OfficialKris/ev-microcontroller/kicad/ev-microcontroller.kicad_pcb

## KiCad design kicad/ev-microcontroller.kicad_pcb (2022-10-09)

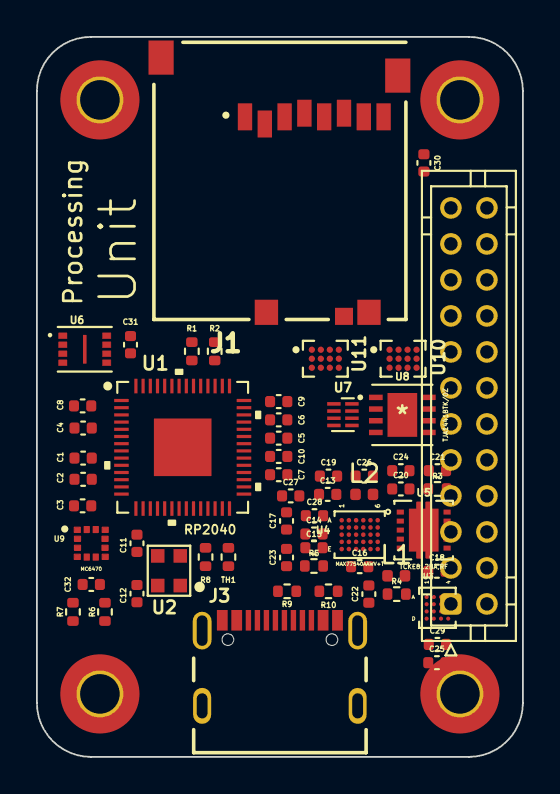
[picture p1: board ev-microcontroller.kicad_pcb from above]

Board: 2 copper layers, 27.0 x 40.0 mm, 63 parts (0 on the bottom side), 57 nets, no tracks yet.

Parts:
C1, C2, C3, C4, C5, C6, C7, C8, C9, C10, C12, C13, C14, C20, C23, C24, C25, C27, C30, C31, C32: 0.1µF; C_0402_1005Metric
C11: 15pF; C_0402_1005Metric
C15, C16, C17, C22, C26, C28, C29: 22µF; C_0402_1005Metric
C18, C19: 1µF; C_0402_1005Metric
C21: 100pF; C_0402_1005Metric
H1, H2, H3, H4: M2; MountingHole_2.2mm_M2_Pad_TopBottom
J1: MEM2051-00-195-00-A_REVC; GCT_MEM2051-00-195-00-A_REVC
J2: Conn_02x20_Odd_Even; JST_PHD_B24B-PHDSS_2x12_P2.00mm_Vertical
J3: USB4105-GF-A; GCT_USB4105-GF-A
L1, L2: 0.47µH; L_0402_1005Metric
R1, R2: 27.4; R_0402_1005Metric
R3: 36k; R_0402_1005Metric
R4: 75k; R_0402_1005Metric
R5: 100k; R_0402_1005Metric
R6, R7: 4.7k; R_0402_1005Metric
R8: 470k; R_0402_1005Metric
R9, R10: 5.1k; R_0402_1005Metric
TH1: NTC; R_0402_1005Metric
U1: RP2040; IC57_RP2040
U2: DSC1001DI1-025.0000T; OSCDFN250X200X89-4N
U3: FPF3042UCX
U4: MAX77540AAWV+T; 21-100414_W302P2Z+1_MXM
U5: TCKE812NA,RF; WSON10B_TOS
U6: GD25Q40CEIGR; PSON50P200X300X50-9N
U7: UM3202; DFN-8_1.7x1.35mm_P0.4mm
U8: TJA1441BTK/0Z; HVSON8_TJA1441BTK_0Z_NXP
U9: MC6470; PQFN50P200X200X100-12N
U10, U11: MAX11613EWCT; BGA12N50P3X4_188X221X69N

Connections:
+1V1: C8.1, C9.1, C10.1, U1.23 (DVDD), U1.45 (VREG_VOUT), U1.50 (DVDD)
+3V3: C1.1, C2.1, C3.1, C4.1, C5.1, C6.1, C7.1, C12.1, C22.2, C26.2, C29.2, C30.1, C31.1, C32.1, J1.4 (VDD), J2.11, J2.13, L2.1, R6.1, R7.1, R8.1, U1.1 (IOVDD), U1.10 (IOVDD), U1.22 (IOVDD), U1.26 (RUN), U1.33 (IOVDD), U1.42 (IOVDD), U1.43 (ADC_AVDD), U1.44 (VREG_VIN), U1.48 (USB_VDD), U1.49 (IOVDD), U2.4 (VDD), U4.C6 (SNS2), U6.8 (VCC), U10.C1 (VDD), U11.C1 (VDD)
+5V: C15.2, C16.2, C17.2, J2.12, J2.14, L1.1, U4.C1 (SNS1), U8.3 (VCC)
/MCU/CLOCK: C11.1, U1.20 (XIN), U2.3 (OUT)
/Power/V_OUT: C19.1, C27.1, C28.2, U4.A3 (IN1), U4.A4 (IN2), U4.C2 (EN1), U4.C5 (EN2), U4.E5 (SYS), U5.6 (VOUT), U5.7 (VOUT), U5.8 (VOUT)
CAN_HI: J2.2, J2.4
CAN_LO: J2.1, J2.3, U8.6 (CANL)
DN: J3.A7 (DN1), J3.B7 (DN2), R2.2
DP: J3.A6 (DP1), J3.B6 (DP2), R1.2
GND: C1.2, C2.2, C3.2, C4.2, C5.2, C6.2, C7.2, C8.2, C9.2, C10.2, C11.2, C12.2, C13.2, C14.1, C15.1, C16.1, C17.1, C18.2, C19.2, C21.2, C22.1, C23.2, C24.2, C26.1, C27.2, C28.1, C29.1, C30.2, C31.2, H1.1, H2.1, H3.1, H4.1, J1.6 (VSS), J1.10 (SHIELD), J1.11 (SHIELD), J1.12 (SHIELD), J1.13 (SHIELD), J2.8, J2.15, J2.16, J3.A1_B12 (GND), J3.B1_A12 (GND), J3.S1 (SHELL_GND), J3.S2 (SHELL_GND), J3.S3 (SHELL_GND), J3.S4 (SHELL_GND), R3.2, R4.2, R5.1, R9.2, R10.1, TH1.2, U1.19 (TESTEN), U1.57 (GND), U2.2 (GND), U3.D1 (GND), U3.D2 (GND), U4.A1 (PGND1), U4.A6 (PGND2), U4.C3 (I2C_EN), U4.C4 (IRQB), U4.D3 (ADDR), U4.D5 (ALT_IN), U4.D6 (SDA), U4.E3 (AGND), U4.E6 (SCL), U5.11 (GND), U6.4 (VSS), U8.2 (GND), U8.8 (S), U9.1 (A5), U9.9 (GND), U10.B1 (GND), U10.B2 (GND), U10.B3 (GND), U10.B4 (GND), U10.C2 (GND), U11.B1 (GND), U11.B2 (GND), U11.B3 (GND), U11.B4 (GND), U11.C2 (GND)
GPIO_1: J2.18, U1.29 (GPIO18)
GPIO_2: J2.20, U1.30 (GPIO19)
GPIO_3: J2.22, U1.31 (GPIO20)
GPIO_4: J2.24, U1.32 (GPIO21)
GPIO_8: U1.18 (GPIO15), U1.37 (GPIO25)
GPIO_12_A1: J2.17, U1.41 (GPIO29/ADC3)
GPIO_13_A2: J2.19, U1.40 (GPIO28/ADC2)
GPIO_14_A3: J2.21, U1.39 (GPIO27/ADC1)
GPIO_CAN_TXD: U1.27 (GPIO16), U1.28 (GPIO17)
GPIO_CD: J1.9 (CD), U1.13 (GPIO10)
GPIO_TEMP: R8.2, TH1.1, U1.38 (GPIO26/ADC0)
unnamed: C18.1, U4.E1 (FPWM1B), U4.E2 (FPWM2B), U4.E4 (VL)
unnamed: C20.1, U4.B1 (BST1)
unnamed: C20.2, L1.2, U4.A2 (LX1), U4.B2 (LX1)
unnamed: C21.1, U5.1 (DV/DT)
unnamed: C23.1, U4.D4 (VDD)
unnamed: C25.1, U4.B6 (BST2)
unnamed: C25.2, L2.2, U4.A5 (LX2), U4.B5 (LX2)
unnamed: C32.2, U9.3 (VDDIO), U9.7 (VDDM)
unnamed: J3.A5 (CC1), R9.1
unnamed: J3.B5 (CC2), R10.2
unnamed: R1.1, U1.47 (USB_DP)
unnamed: R2.1, U1.46 (USB_DM)
unnamed: R3.1, U5.10 (ILIM)
unnamed: R4.1, U4.D2 (SEL2)
unnamed: R5.2, U4.D1 (SEL1)
QSPI_SCLK: U1.52 (QSPI_SCLK), U6.6 (SCLK)
QSPI_SD0: U1.53 (QSPI_SD0), U6.5 (SI(IO0))
QSPI_SD1: U1.55 (QSPI_SD1), U6.2 (SO(IO1))
QSPI_SD2: U1.54 (QSPI_SD2), U6.3 (WP#(IO2))
QSPI_SD3: U1.51 (QSPI_SD3), U6.7 (HOLD#(IO3))
QSPI_SS: U1.56 (QSPI_SS_N), U6.1 (CS#)
SCL_0: U1.12 (GPIO9), U11.C4 (SCL)
SCL_1: R7.2, U1.9 (GPIO7), U9.12 (SCL), U10.C4 (SCL)
SDA_0: U1.11 (GPIO8), U11.C3 (SDA)
SDA_1: R6.2, U1.8 (GPIO6), U9.2 (SDA), U10.C3 (SDA)
SD_CLK: J1.5 (CLK), U1.7 (GPIO5)
SD_CMD: J1.3 (CMD), U1.6 (GPIO4)
SD_DAT0: J1.7 (DAT0), U1.2 (GPIO0)
SD_DAT1: J1.8 (DAT1), U1.3 (GPIO1)
SD_DAT2: J1.1 (DAT2), U1.4 (GPIO2)
SD_DAT3: J1.2 (CD/DAT3), U1.5 (GPIO3)
SWCIK: J2.9, U1.24 (SWCLK)
SWDIO: J2.10, U1.25 (SWDIO)
VIN: U3.A4 (VIN), U3.B4 (VIN), U3.C4 (VIN)
V_BUS: C14.2, J3.A4_B9 (VBUS), J3.B4_A9 (VBUS), U3.A1 (VBUS), U3.B1 (VBUS), U3.C1 (VBUS)
V_SEL: C13.1, C24.1, U3.A2 (VOUT), U3.A3 (VOUT), U3.B3 (VOUT), U3.C3 (VOUT), U5.2 (EN/UVLO), U5.3 (VIN), U5.4 (VIN), U5.5 (VIN)
