OfficialKris/ev-microcontroller/(commit log)

2022-05-13 Initial KiCad 6.0 commit
    [ev-microcontroller.kicad_pcb, ev-microcontroller.kicad_sch]
2022-05-14 Added external components and updated schematic info
    [ev-microcontroller.kicad_sch]
2022-05-14 Updated sym-lib-table with NCP1090DRG.kicad_sym
2022-06-25 First major revision
    [conenctors.kicad_sch, ev-microcontroller.kicad_pcb, ev-microcontroller.kicad_sch, mcu.kicad_sch, memory.kicad_sch, peripherals.kicad_sch, power.kicad_sch]
2022-06-25 Moved KiCad files to separate folder
    [conenctors.kicad_sch, ev-microcontroller.kicad_pcb, ev-microcontroller.kicad_sch, mcu.kicad_sch, memory.kicad_sch, peripherals.kicad_sch, power.kicad_sch]
2022-06-30 Connected all remaining unconnected pins
    [conenctors.kicad_sch, ev-microcontroller.kicad_sch, mcu.kicad_sch, memory.kicad_sch, peripherals.kicad_sch, power.kicad_sch]
2022-07-10 Updated symbol and footprint libraries
    Added descriptions to symbols
    Added new footprints for power supply refactor
2022-10-08 Updated schematic with various changes
    Increased size of small components
    Updated title/spec sheet
    Cleaned footprints
    Other small changes as well
    [conenctors.kicad_sch, ev-microcontroller.kicad_pcb, ev-microcontroller.kicad_sch, mcu.kicad_sch, memory.kicad_sch, peripherals.kicad_sch, power.kicad_sch]
2022-10-09 Changed pinout on main pcb connector
    [conenctors.kicad_sch, ev-microcontroller.kicad_sch, mcu.kicad_sch, peripherals.kicad_sch]
2022-10-09 Modified size of pcb board
    [ev-microcontroller.kicad_pcb]
